dbwalker0min/motion-sensor-hardware/enclosure/cad/README.md

Onshape: https://cad.onshape.com/documents/93f6685658c5f5399bfbcb53/w/68bb8d29807adcc07b397ad7/e/c1de605d9eb46ca5394788e5

Version: V1
