dbwalker0min/motion-sensor-hardware/hardware/Calculations/AP62200_AP62300_AP62400_Power-Calculation_Design.xlsx

Sheet: Power Loss
 |  |  |  |  |  |  |  |  |  | Note: In order for the design file to work
Version 2.1 |  |  |  |  |  |  |  |  |  |  | in local region.
 |  |  |  |  |  |  |  |  |  | 1. Go to File, then Option.
Power Loss Calculation |  |  |  |  |  |  |  |  |  | 2. Select Advance.
Part Munber | AP62200T |  |  |  |  |  |  |  |  | 3. Unselect Use System separator
Switching Frequency | 750 | kHz |  | On Time | 908.6280149 | ns
Input Voltage (4.2V-18V) | 5.0 | V |  | Duty Cycle | 0.68
Output Voltage (0.765V-7V) | 3.3 | V |  | Effective Output Resistance | 3.3 | Ohm
Output Current | 1.0 | A |  |  |  |  |  |  |  | 4. Change to local Decimal/Thousand separator to "." or ","
 |  |  |  | Iupper,rms | 0.83 | A |  |  |  | 5. Click OK.
OUTPUT INDUCTOR |  |  |  | Ilower,rms | 0.56 | A
Inductor Current Ripple Ratio (∆I/ILOAD) | 45 | %
Recommended Inductor | 1.7 | uH |  | Current Ripple | 0.15 | Ap-p
Output Inductor (Isat > 3A) | 10.0 | uH |  | Output Voltage Ripple | 0.9406666667 | mVp-p |  | Conduction Loss | Switching Loss
DCR | 20 | mOhm |  |  |  |  | Upper MOSFET | 0.070 | 0.016
 |  |  |  |  |  |  | Lower MOSFET | 0.018 | 0.025
OUTPUT CAPACITOR |  |  |  |  |  |  | Driver |  | 0.002
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
