dbwalker0min/motion-sensor-hardware/enclosure/stl/Base+-+Enclosure+Base.stl

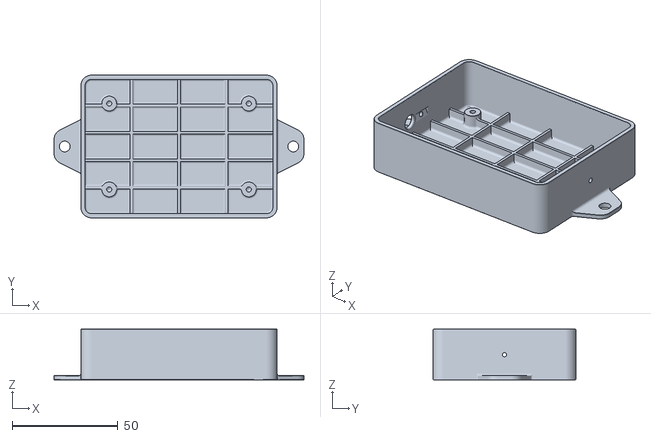
[picture p1: CAD file, 2025-10-16]
enclosure/stl/Base+-+Enclosure+Base.stl
118.3 x 67.5 x 24.0
