dbwalker0min/motion-sensor-hardware/enclosure/stl/Base+-+Enclosure+Lid.stl

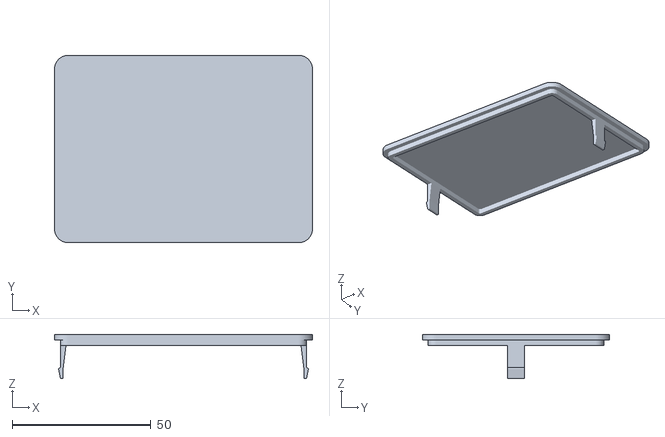
[picture p2: CAD file, 2025-10-16]
enclosure/stl/Base+-+Enclosure+Lid.stl
92.9 x 67.5 x 16.0
