dbwalker0min/motion-sensor-hardware/hardware/motion-sensor-hardware.kicad_pcb

## KiCad design hardware/motion-sensor-hardware.kicad_pcb (2025-10-09)

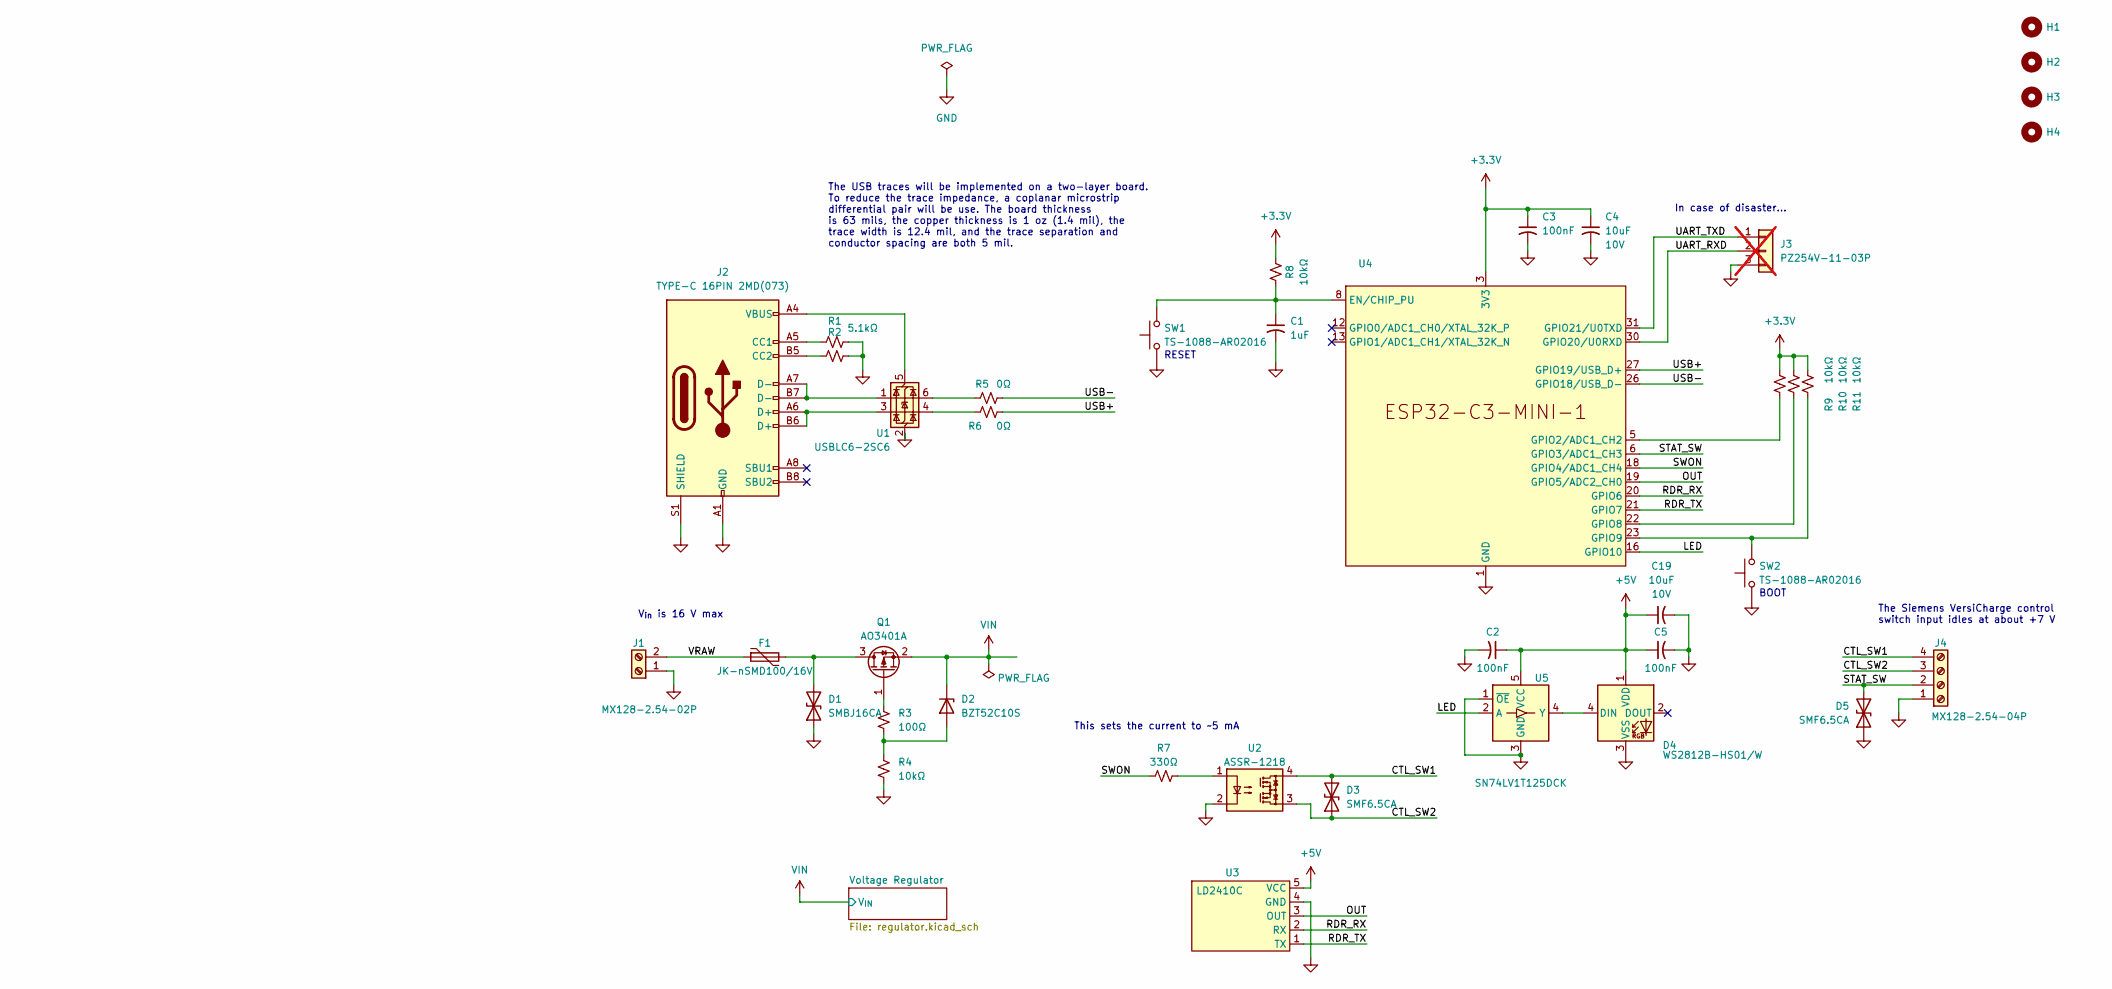
[picture p3: schematic motion-sensor-hardware.kicad_sch, Motion Sensor/Charge Control, part in row 1, column 2]

Parts:
C1: 1uF; C_0603_1608Metric; Voltage 50V; Tolerance ±10%; JLCPCB PN C15849
C2, C3, C5: 100nF; C_0603_1608Metric; Voltage 50V; Tolerance ±10%; JLCPCB PN C14663
C4, C19: 10uF; C_0603_1608Metric; Voltage 10V; Tolerance ±10%; JLCPCB PN C19702
D1: SMBJ16CA; D_SMB; JLCPCB PN C113990
D2: BZT52C10S; D_SOD-323; JLCPCB PN C19077446
D3, D5: SMF6.5CA; D_SOD-123F; JLCPCB PN C19077501
D4: WS2812B-HS01/W; LED_WS2812B_PLCC4_5.0x5.0mm_P3.2mm; JLCPCB PN C22371521
F1: JK-nSMD100/16V; Fuse_1206_3216Metric; JLCPCB PN C2830246
H1, H2, H3, H4: MountingHole; MountingHole_3.2mm_M3
J1: MX128-2.54-02P; JLCPCB PN C5188442
J2: TYPE-C 16PIN 2MD(073); USB_C_Receptacle_GCT_USB4105-xx-A_16P_TopMnt_Horizontal; JLCPCB PN C2765186
J3: PZ254V-11-03P; PinHeader_1x03_P2.54mm_Vertical; JLCPCB PN C2937625; not fitted
J4: MX128-2.54-04P; JLCPCB PN C5188444
Q1: AO3401A; TSOT-23; JLCPCB PN C15127
R1, R2: 5.1kΩ; R_0603_1608Metric; Tolerance ±1%; JLCPCB PN C23186
R3: 100Ω; R_0603_1608Metric; Tolerance ±1%; JLCPCB PN C22775
R4, R8, R9, R10, R11: 10kΩ; R_0603_1608Metric; Tolerance ±1%; JLCPCB PN C25804
R5, R6: 0Ω; R_0603_1608Metric; Tolerance nan; JLCPCB PN C21189
R7: 330Ω; R_0603_1608Metric; Tolerance ±1%; JLCPCB PN C23138
SW1, SW2: TS-1088-AR02016; SW_TS-1088-xx020xx_XUNPU; JLCPCB PN C720477
U1: USBLC6-2SC6; SOT-23-6; JLCPCB PN C7519
U2: ASSR-1218; SO-4_4.4x4.3mm_P2.54mm; JLCPCB PN C6747780
U3: LD2410C; JLCPCB PN C19723500
U4: ESP32-C3-MINI-1-N4; ESP32-C6-MINI-1; JLCPCB PN C2838502
U5: SN74LV1T125DCK; SOT-353_SC-70-5; JLCPCB PN C75925

Connections:
+3.3V: C3.1, C4.1, R8.1, R9.1, R10.1, R11.1, U4.3 (3V3); also elsewhere on the board
+5V: C2.1, C5.1, C19.1, D4.1 (VDD), U3.5 (VCC), U5.5 (VCC); also elsewhere on the board
/CTL_SW1: D3.2 (A2), J4.4, U2.4
/CTL_SW2: D3.1 (A1), J4.3, U2.3
/LED: U4.16 (GPIO10), U5.2 (A)
/OUT: U3.3 (OUT), U4.19 (GPIO5/ADC2_CH0)
/RDR_RX: U3.2 (RX), U4.20 (GPIO6)
/RDR_TX: U3.1 (TX), U4.21 (GPIO7)
/STAT_SW: D5.2 (A2), J4.2, U4.6 (GPIO3/ADC1_CH3)
/SWON: R7.1, U4.18 (GPIO4/ADC1_CH4)
/UART_RXD: J3.2, U4.30 (GPIO20/U0RXD)
/UART_TXD: J3.1, U4.31 (GPIO21/U0TXD)
/USB+: R6.2, U4.27 (GPIO19/USB_D+)
/USB-: R5.2, U4.26 (GPIO18/USB_D-)
/VRAW: F1.1, J1.2
GND: C1.2, C2.2, C3.2, C4.2, C5.2, C19.2, D1.1 (A1), D4.3 (VSS), D5.1 (A1), J1.1, J2.A1 (GND), J2.A12 (GND), J2.B1 (GND), J2.B12 (GND), J2.S1 (SHIELD), J3.3, J4.1, R1.2, R2.2, R4.2, SW1.1, SW2.1, U1.2 (GND), U2.2, U3.4 (GND), U4.1 (GND), U4.2 (GND), U4.11 (GND), U4.14 (GND), U4.36 (GND), U4.37 (GND), U4.38 (GND), U4.39 (GND), U4.40 (GND), U4.41 (GND), U4.42 (GND), U4.43 (GND), U4.44 (GND), U4.45 (GND), U4.46 (GND), U4.47 (GND), U4.48 (GND), U4.49 (GND), U4.50 (GND), U4.51 (GND), U4.52 (GND), U4.53 (GND), U5.1 (~OE), U5.3 (GND); also elsewhere on the board
unnamed: D1.2 (A2), F1.2, Q1.3 (D)
unnamed: D2.2 (A), R3.2, R4.1
unnamed: D4.4 (DIN), U5.4 (Y)
unnamed: J2.A5 (CC1), R1.1
unnamed: J2.B5 (CC2), R2.1
unnamed: J2.A6 (D+), J2.B6 (D+), U1.3 (I/O2)
unnamed: J2.A7 (D-), J2.B7 (D-), U1.1 (I/O1)
unnamed: Q1.1 (G), R3.1
unnamed: R5.1, U1.6 (I/O1)
unnamed: R6.1, U1.4 (I/O2)
unnamed: R7.2, U2.1
unnamed: J2.A4 (VBUS), J2.A9 (VBUS), J2.B4 (VBUS), J2.B9 (VBUS), U1.5 (VBUS)
unnamed: C1.1, R8.2, SW1.2, U4.8 (EN/CHIP_PU)
unnamed: R9.2, U4.5 (GPIO2/ADC1_CH2)
unnamed: R10.2, U4.22 (GPIO8)
unnamed: R11.2, SW2.2, U4.23 (GPIO9)
VIN: D2.1 (K), Q1.2 (S); also elsewhere on the board

Notes on the sheet:
In case of disaster...
This sets the current to ~5 mA
BOOT
V_{in} is 16 V max
The Siemens VersiCharge control switch input idles at about +7 V
The USB traces will be implemented on a two-layer board. To reduce the trace impedance, a coplanar microstrip differential pair will be use. The board thickness is 63 mils, the copper thickness is 1 oz (1.4 mil), the trace width is 12.4 mil, and the trace separation and conductor spacing are both 5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
RESET

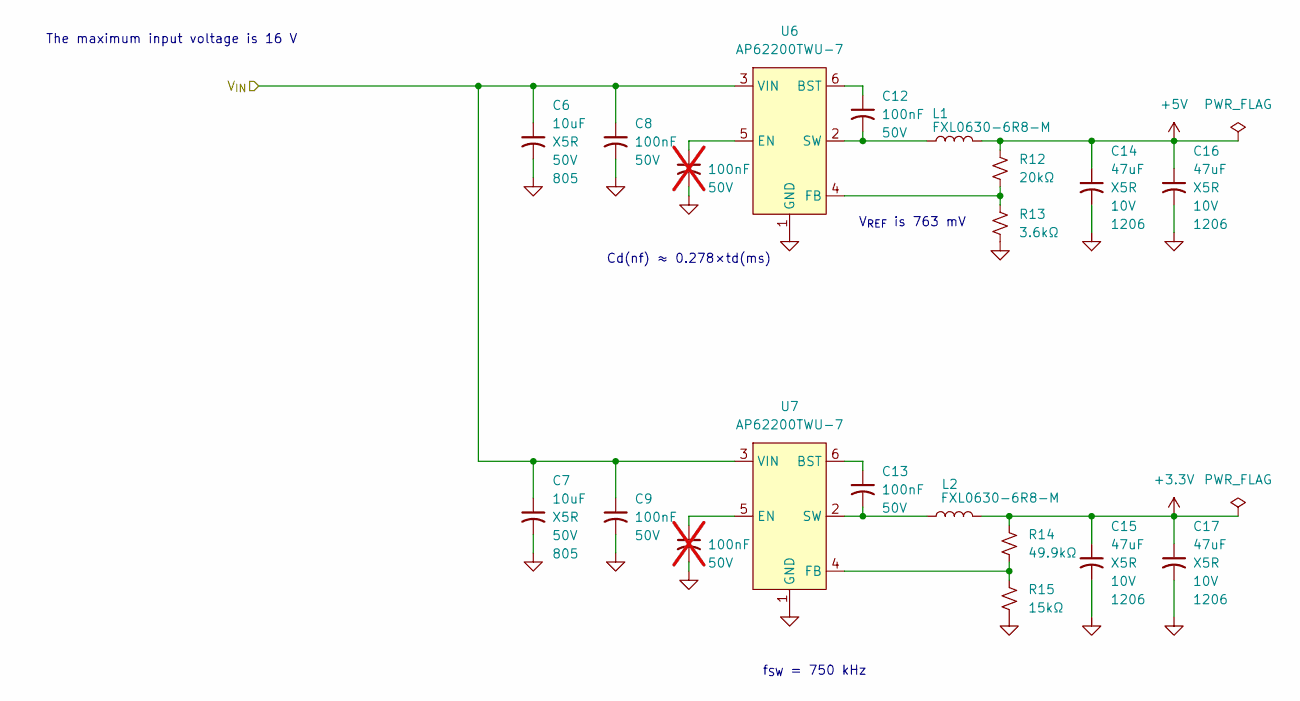
[picture p4: schematic regulator.kicad_sch]

Parts:
C6, C7: 10uF; C_0805_2012Metric; Voltage 50V; Tolerance ±10%; JLCPCB PN C440198
C8, C9, C12, C13: 100nF; C_0603_1608Metric; Voltage 50V; Tolerance ±10%; JLCPCB PN C14663
C10, C11: 100nF; C_0603_1608Metric; Voltage 50V; Tolerance ±10%; JLCPCB PN C14663; not fitted
C14, C15, C16, C17: 47uF; C_1206_3216Metric; Voltage 10V; Tolerance ±20%; JLCPCB PN C96123
L1, L2: FXL0630-6R8-M; L_Changjiang_FXL0630; JLCPCB PN C167221
R12: 20kΩ; R_0603_1608Metric; Tolerance ±1%; JLCPCB PN C4184
R13: 3.6kΩ; R_0603_1608Metric; Tolerance ±1%; JLCPCB PN C22980
R14: 49.9kΩ; R_0603_1608Metric; Tolerance ±1%; JLCPCB PN C23184
R15: 15kΩ; R_0603_1608Metric; Tolerance ±1%; JLCPCB PN C22809
U6, U7: AP62200TWU-7; SOT-23-6; JLCPCB PN C2895288

Connections:
+3.3V: C15.1, C17.1, L2.2, R14.1; also elsewhere on the board
+5V: C14.1, C16.1, L1.2, R12.1; also elsewhere on the board
GND: C6.2, C7.2, C8.2, C9.2, C10.2, C11.2, C14.2, C15.2, C16.2, C17.2, R13.2, R15.2, U6.1 (GND), U7.1 (GND); also elsewhere on the board
unnamed: C12.1, U6.6 (BST)
unnamed: C10.1, U6.5 (EN)
unnamed: R12.2, R13.1, U6.4 (FB)
unnamed: C12.2, L1.1, U6.2 (SW)
unnamed: C13.1, U7.6 (BST)
unnamed: C11.1, U7.5 (EN)
unnamed: R14.2, R15.1, U7.4 (FB)
unnamed: C13.2, L2.1, U7.2 (SW)
VIN: C6.1, C7.1, C8.1, C9.1, U6.3 (VIN), U7.3 (VIN); also elsewhere on the board

Notes on the sheet:
f_{SW} = 750 kHz
V_{REF} is 763 mV
Cd(nf) ≈ 0.278×td(ms)
The maximum input voltage is 16 V

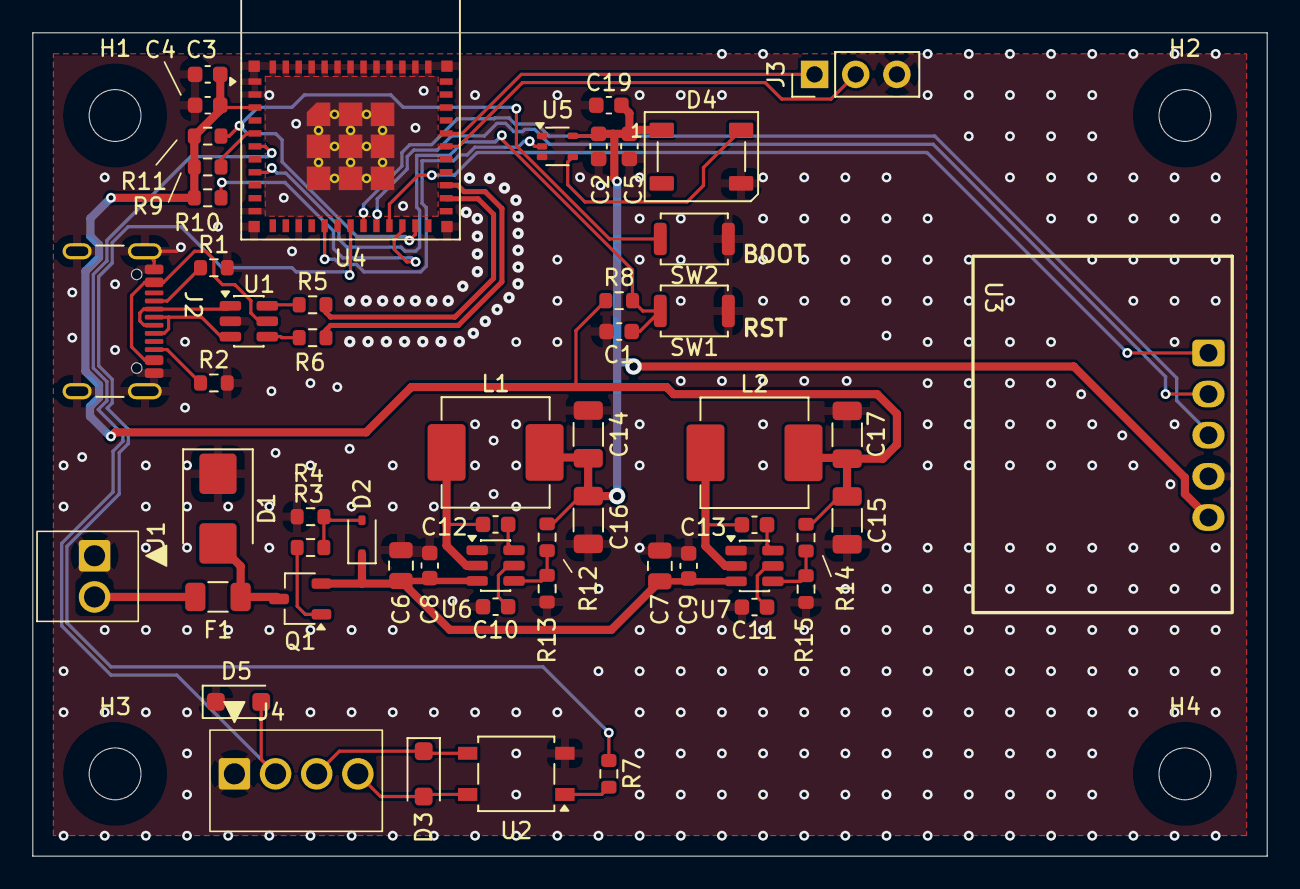
[picture p5: board motion-sensor-hardware.kicad_pcb from above]

Board: 2 copper layers, 76.2 x 50.8 mm, 59 parts (0 on the bottom side), 41 nets.
