dbwalker0min/motion-sensor-hardware/firmware/esphome/packages/base_c3mini.yaml

# Defaults (can be overridden by each device file)
substitutions:
  # These are the defined GPIO pins for Rev B
  pixel_pin: GPIO10
  radar_tx_pin: GPIO7
  radar_rx_pin: GPIO6
  radar_out_pin: GPIO5
  charger_status_pin: GPIO3
  charger_enable_pin: GPIO4
  
esp32:
  board: esp32-c3-devkitm-1
  variant: esp32c3
  framework:
    type: esp-idf

# Use defaults for these components
logger:
  level: DEBUG
