dbwalker0min/motion-sensor-hardware/firmware/esphome/external_components/ld2410/ld2410.h

#pragma once
#include "esphome/core/defines.h"
#include "esphome/core/component.h"
#ifdef USE_BINARY_SENSOR
#include "esphome/components/binary_sensor/binary_sensor.h"
#endif
#ifdef USE_SENSOR
#include "esphome/components/sensor/sensor.h"
#endif
#ifdef USE_NUMBER
#include "esphome/components/number/number.h"
#endif
#ifdef USE_SWITCH
#include "esphome/components/switch/switch.h"
#endif
#ifdef USE_BUTTON
#include "esphome/components/button/button.h"
#endif
#ifdef USE_SELECT
#include "esphome/components/select/select.h"
#endif
#ifdef USE_TEXT_SENSOR
#include "esphome/components/text_sensor/text_sensor.h"
#endif
#include "esphome/components/ld24xx/ld24xx.h"
#include "esphome/components/uart/uart.h"
#include "esphome/core/automation.h"
#include "esphome/core/helpers.h"

#include <array>

namespace esphome {
namespace ld2410 {

using namespace ld24xx;

static constexpr uint8_t MAX_LINE_LENGTH = 46;  // Max characters for serial buffer
static constexpr uint8_t TOTAL_GATES = 9;       // Total number of gates supported by the LD2410

class LD2410Component : public Component, public uart::UARTDevice {
#ifdef USE_BINARY_SENSOR
  SUB_BINARY_SENSOR(out_pin_presence_status)
  SUB_BINARY_SENSOR(moving_target)
  SUB_BINARY_SENSOR(still_target)
  SUB_BINARY_SENSOR(target)
#endif
#ifdef USE_SENSOR
  SUB_SENSOR_WITH_DEDUP(light, uint8_t)
  SUB_SENSOR_WITH_DEDUP(detection_distance, int)
  SUB_SENSOR_WITH_DEDUP(moving_target_distance, int)
  SUB_SENSOR_WITH_DEDUP(moving_target_energy, uint8_t)
  SUB_SENSOR_WITH_DEDUP(still_target_distance, int)
  SUB_SENSOR_WITH_DEDUP(still_target_energy, uint8_t)
#endif
#ifdef USE_TEXT_SENSOR
  SUB_TEXT_SENSOR(version)
  SUB_TEXT_SENSOR(mac)
  SUB_TEXT_SENSOR(auto_calibration_status)
#endif
#ifdef USE_NUMBER
  SUB_NUMBER(light_threshold)
  SUB_NUMBER(max_move_distance_gate)
  SUB_NUMBER(max_still_distance_gate)
  SUB_NUMBER(timeout)
  SUB_NUMBER(autocalibrate_seconds)
#endif
#ifdef USE_SELECT
  SUB_SELECT(baud_rate)
  SUB_SELECT(distance_resolution)
  SUB_SELECT(light_function)
  SUB_SELECT(out_pin_level)
#endif
#ifdef USE_SWITCH
  SUB_SWITCH(bluetooth)
  SUB_SWITCH(engineering_mode)
#endif
#ifdef USE_BUTTON
  SUB_BUTTON(factory_reset)
  SUB_BUTTON(query)
  SUB_BUTTON(restart)
  SUB_BUTTON(autocalibrate)
#endif

 public:
  void setup() override;
  void dump_config() override;
  void loop() override;
  void set_light_out_control();
#ifdef USE_NUMBER
  void set_gate_still_threshold_number(uint8_t gate, number::Number *n);
  void set_gate_move_threshold_number(uint8_t gate, number::Number *n);
  void set_max_distances_timeout();
  void set_gate_threshold(uint8_t gate);
#endif
#ifdef USE_SENSOR
  void set_gate_move_sensor(uint8_t gate, sensor::Sensor *s);
  void set_gate_still_sensor(uint8_t gate, sensor::Sensor *s);
#endif
  void set_bluetooth_password(const std::string &password);
  void set_engineering_mode(bool enable);
  void read_all_info();
  void restart_and_read_all_info();
  void set_bluetooth(bool enable);
  void set_distance_resolution(const std::string &state);
  void set_baud_rate(const std::string &state);
  void factory_reset();
  void autocalibrate(); // uses autocal_seconds
  void autocalibrate(uint16_t autocal_seconds);
  void set_autocal_seconds(uint16_t s) { autocal_seconds_ = s; }
  uint16_t get_autocal_seconds() const { return autocal_seconds_; }
 protected:
  void send_command_(uint8_t command_str, const uint8_t *command_value, uint8_t command_value_len);
  uint16_t autocal_seconds_{30};  // default autocalibration time in seconds
  void set_config_mode_(bool enable);
  void handle_periodic_data_();
  bool handle_ack_data_();
  void readline_(int readch);
  void query_parameters_();
  void get_version_();
  void get_mac_();
  void get_distance_resolution_();
  void query_light_control_();
  void restart_();

  uint8_t light_function_ = 0;
  uint8_t light_threshold_ = 0;
  uint8_t out_pin_level_ = 0;
  uint8_t buffer_pos_ = 0;  // where to resume processing/populating buffer
  uint8_t buffer_data_[MAX_LINE_LENGTH];
  uint8_t mac_address_[6] = {0, 0, 0, 0, 0, 0};
  uint8_t version_[6] = {0, 0, 0, 0, 0, 0};
  bool bluetooth_on_{false};
#ifdef USE_NUMBER
  std::array<number::Number *, TOTAL_GATES> gate_move_threshold_numbers_{};
  std::array<number::Number *, TOTAL_GATES> gate_still_threshold_numbers_{};
#endif
#ifdef USE_SENSOR
  std::array<SensorWithDedup<uint8_t> *, TOTAL_GATES> gate_move_sensors_{};
  std::array<SensorWithDedup<uint8_t> *, TOTAL_GATES> gate_still_sensors_{};
#endif
};

}  // namespace ld2410
}  // namespace esphome
