dbwalker0min/motion-sensor-hardware/(commit log)

2025-07-27 Deleted report.txt
    [motion-sensor.kicad_pcb, motion-sensor.kicad_sch]
2025-07-28 Generated artwork
    [motion-sensor-hardware.kicad_pcb, motion-sensor-hardware.kicad_sch, motion-sensor.kicad_pcb]
2025-08-08 Switching converter for 12 V -> 5V. LDO for 5->3
    [BOM.xlsx, motion-sensor-hardware.kicad_sch, regulator.kicad_sch]
2025-08-22 Added car charger circuits
    [LT8608.xlsx, motion-sensor-hardware.kicad_pcb, motion-sensor-hardware.kicad_sch, regulator.kicad_sch]
2025-08-22 Added decoupling cap for LED and bigger cap for module
    [motion-sensor-hardware.kicad_sch, regulator.kicad_sch]
2025-08-28 Schematic relatively complete
    [motion-sensor-hardware.kicad_sch, regulator.kicad_sch]
2025-09-20 Updating regulator to use JLCPCB Basic part
    [AP62200_AP62300_AP62400_Power-Calculation_Design.xlsx, motion-sensor-hardware.kicad_sch, regulator.kicad_sch]
2025-10-02 Ready to restart work!
    [LT8607.xlsx, LT8608.xlsx, motion-sensor-hardware.kicad_sch, regulator.kicad_sch]
2025-10-03 Schematic complete (I think)
    [motion-sensor-hardware.kicad_sch, regulator.kicad_sch]
2025-10-05 Split the two ground planes
    [motion-sensor-hardware.kicad_pcb, motion-sensor-hardware.kicad_sch, regulator.kicad_sch]
2025-10-05 Rev B Submitted
    [bom.csv, designators.csv, motion-sensor-hardware.kicad_pcb, motion-sensor-hardware.kicad_sch, positions.csv, regulator.kicad_sch]
2025-10-07 Got 3D export working
    [motion-sensor-hardware.kicad_pcb, regulator.kicad_sch]
2025-10-09 Fixed screw term pin 1 issue
    [motion-sensor-hardware.kicad_pcb, motion-sensor-hardware.kicad_sch]
2025-10-16 Modified project structure
    [AP62200_AP62300_AP62400_Power-Calculation_Design.xlsx, BOM.xlsx, Base+-+Enclosure+Base.stl, Base+-+Enclosure+Lid.stl, bom.csv, designators.csv, motion-sensor-hardware.kicad_pcb, motion-sensor-hardware.kicad_sch]
2025-10-16 Initial commit of motion sensor firmware
2025-10-24 Added ld2410 sensor
